jrsath/ROS2_ESP32_RaspberryPi_Automated_Assembly_Line/group4_project2_AL/report/README.md

# Report draft

`report.tex` uses the supplied ACRA style. Build with `pdflatex report.tex` twice.
The figures have editable SVG versions and a Python generator.

Replace Group 4 with the final author names. Add the measured lab results and
update the validation section after the revised simulation and physical trials.
The current draft deliberately does not claim physical assembly or inspection
results that have not been measured. Keep the finished report within four pages.
