jrsath/ROS2_ESP32_RaspberryPi_Automated_Assembly_Line/group4_project2_AL/models/packaging/README.md

# Packaging meshes

Separated from the university Box_Lower.stl. No new holder or rails are added.

- box.stl: open body, centred halfway up its 24mm height.
- lid.stl: cover and handle; origin is the underside of the lid roof.
- X is width, Y is length, Z is up. Units are metres.
