jrsath/ROS2_ESP32_RaspberryPi_Automated_Assembly_Line/group4_project2_AL/report/board_interface.pdf

# Project 2 | Board interface

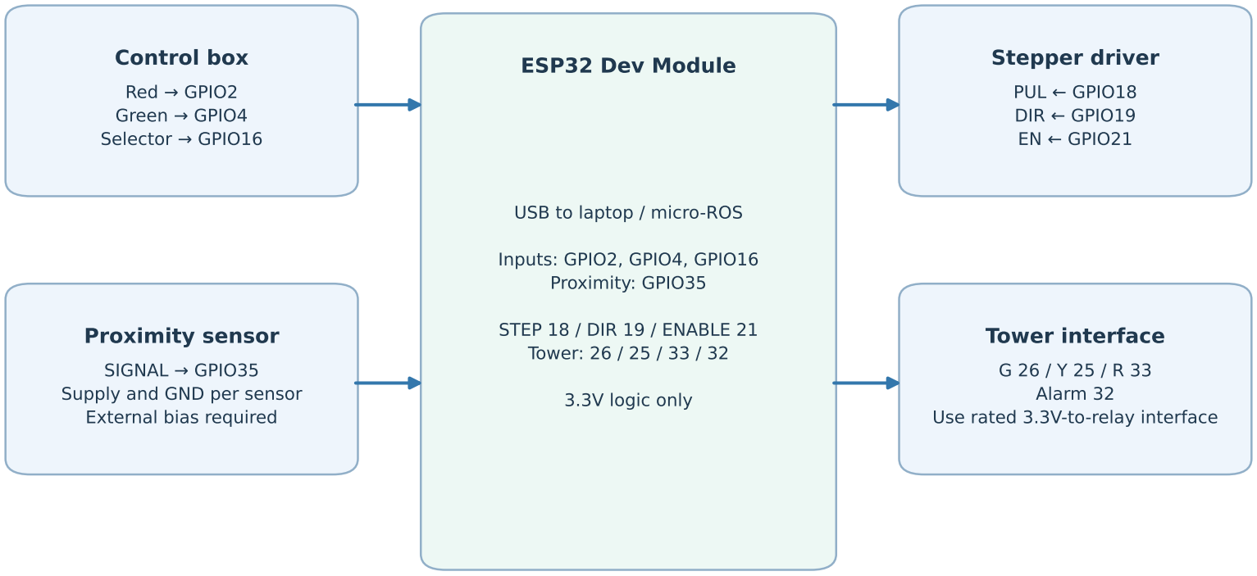
[picture p2: figure]
ESP32 Dev Module; USB to laptop / micro-ROS; Inputs: GPIO2, GPIO4, GPIO16 Proximity: GPIO35; STEP 18 / DIR 19 / ENABLE 21 Tower: 26 / 25 / 33 / 32; 3.3V logic only; Control box; Red; GPIO2; Green; GPIO4; Selector; GPIO16; Proximity sensor; SIGNAL; GPIO35; Supply and GND per sensor External bias required; Stepper driver; PUL; GPIO18; DIR; GPIO19; GPIO21; Tower interface; G 26 / Y 25 / R 33 Alarm 32 Use rated 3.3V-to-relay interface

NC E-stop: separate hardwired power-cut circuit. Feedback pin is not yet assigned.

Pin labels transcribed from the supplied sketch. Connector order and input polarity require confirmation.

Do not connect the tower relay supply or a 5V sensor output directly to an ESP32 GPIO.
