jrsath/ROS2_ESP32_RaspberryPi_Automated_Assembly_Line/group4_project2_AL/report/inspection_trials.csv

sample | actual_condition | prediction | removed_correctly | camera_bypassed | image_file | notes
1 | good
2 | good
3 | good
4 | good
5 | missing_gear
6 | unseated_insert
