jrsath/ROS2_ESP32_RaspberryPi_Automated_Assembly_Line/group4_project2_AL/report/physical_runs.csv

trial | start_time | assembly_s | conveyor_s | inspection_s | packaging_s | total_s | complete_success | maximum_position_error_mm | grip_failure | notes
1
2
3
4
5
