jrsath/ROS2_ESP32_RaspberryPi_Automated_Assembly_Line/group4_project2_AL/report/board_interface.png

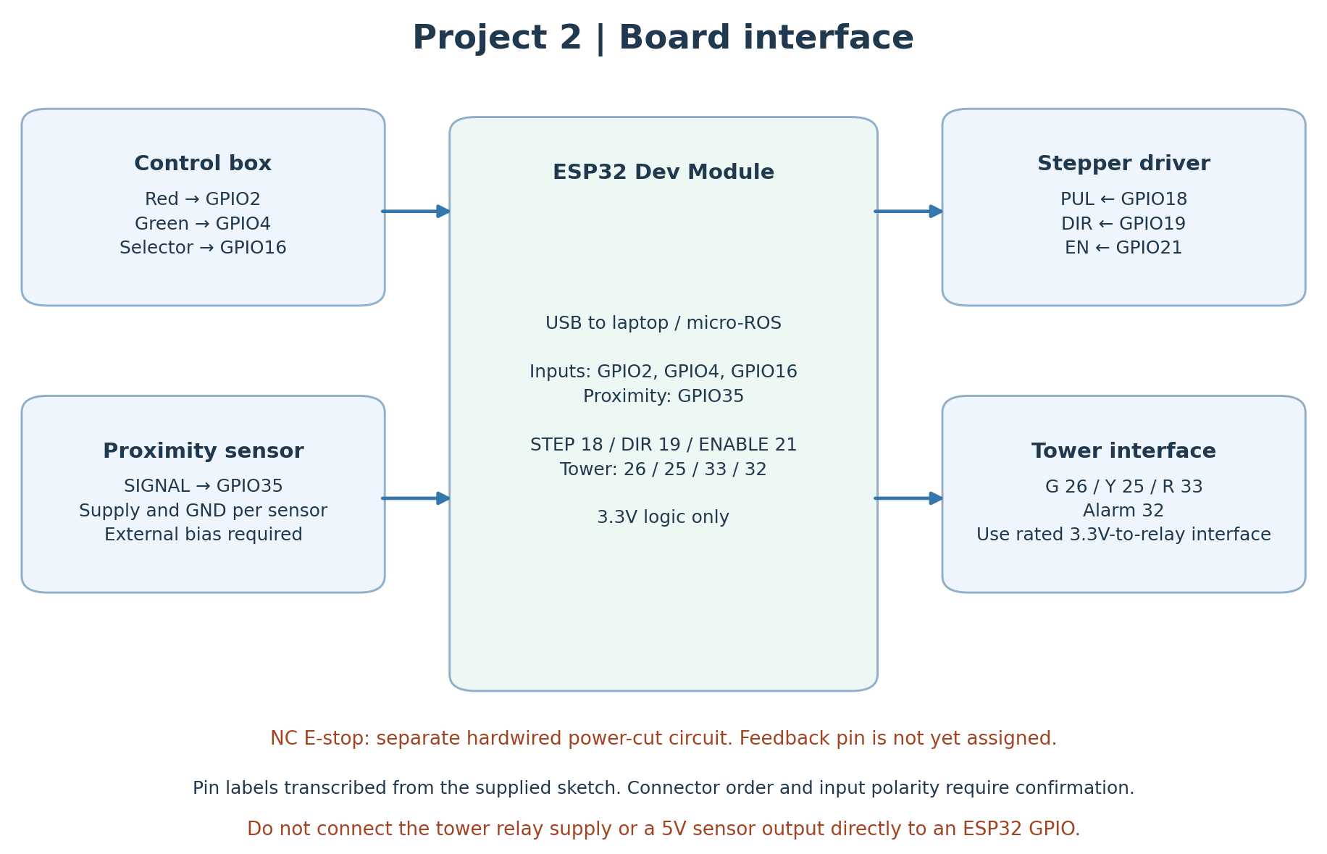
group4_project2_AL/report/board_interface.png
