jrsath/ROS2_ESP32_RaspberryPi_Automated_Assembly_Line/group4_project2_AL/models/v6/assembly_jig.stl

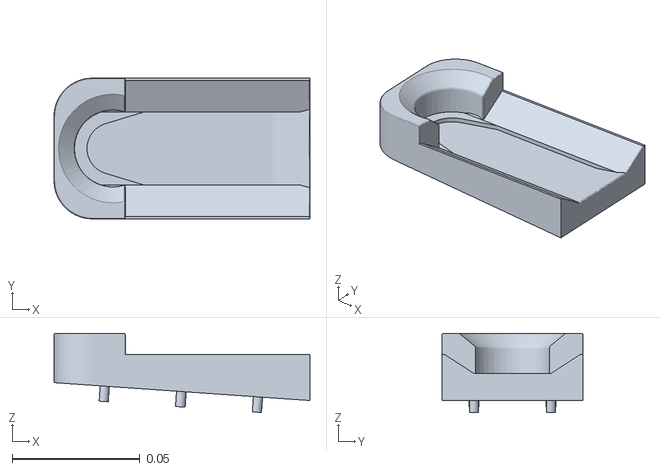
[picture p5: CAD file, 2026-10-29]
group4_project2_AL/models/v6/assembly_jig.stl
0.1 x 0.055 x 0.0309
