jrsath/ROS2_ESP32_RaspberryPi_Automated_Assembly_Line/group4_project2_AL/models/product/1_assembled.STL

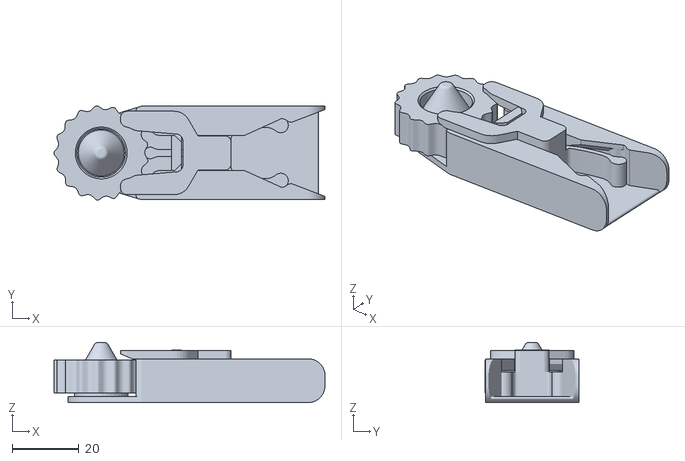
[picture p6: CAD file, 2026-10-29]
group4_project2_AL/models/product/1_assembled.STL
81.2 x 28.2 x 18.0
