jrsath/ROS2_ESP32_RaspberryPi_Automated_Assembly_Line/group4_project2_AL/models/packaging/box.stl

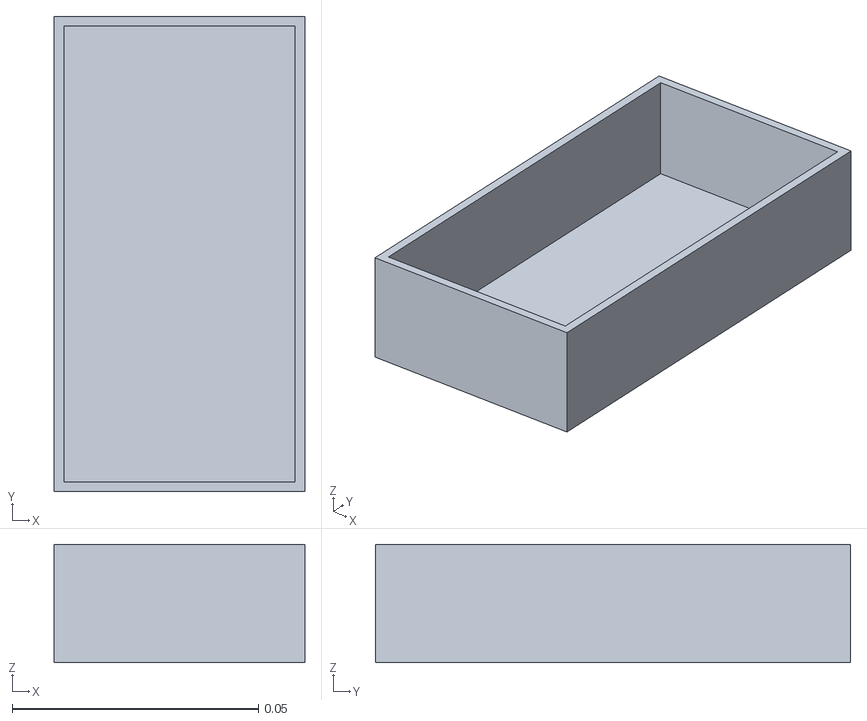
[picture p7: CAD file, 2026-10-29]
group4_project2_AL/models/packaging/box.stl
0.051 x 0.0966 x 0.024
