jrsath/ROS2_ESP32_RaspberryPi_Automated_Assembly_Line/group4_project2_AL/models/product/3V4_centered.stl

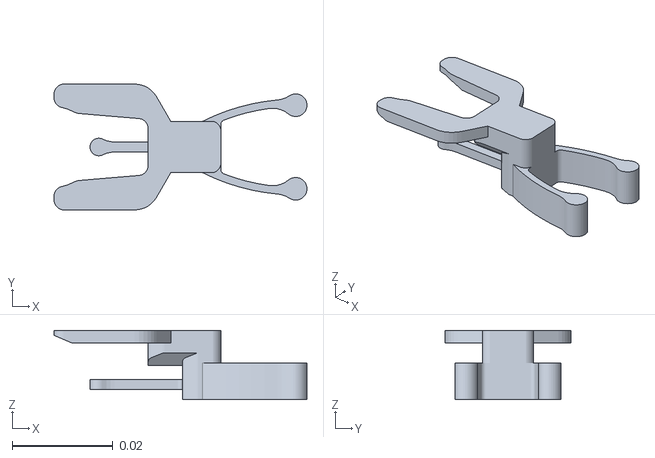
[picture p8: CAD file, 2026-10-29]
group4_project2_AL/models/product/3V4_centered.stl
0.0502 x 0.025 x 0.0138
