jrsath/ROS2_ESP32_RaspberryPi_Automated_Assembly_Line/group4_project2_AL/models/v6/2.stl

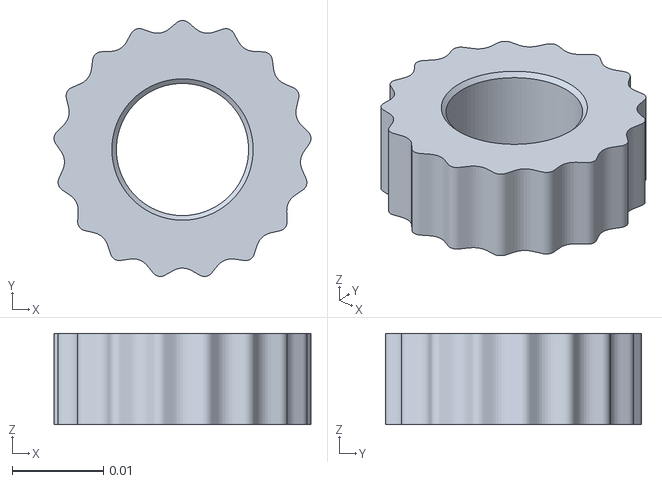
[picture p9: CAD file, 2026-10-29]
group4_project2_AL/models/v6/2.stl
0.0282 x 0.0281 x 0.01
