jrsath/ROS2_ESP32_RaspberryPi_Automated_Assembly_Line/group4_project2_AL/models/packaging/lid.stl

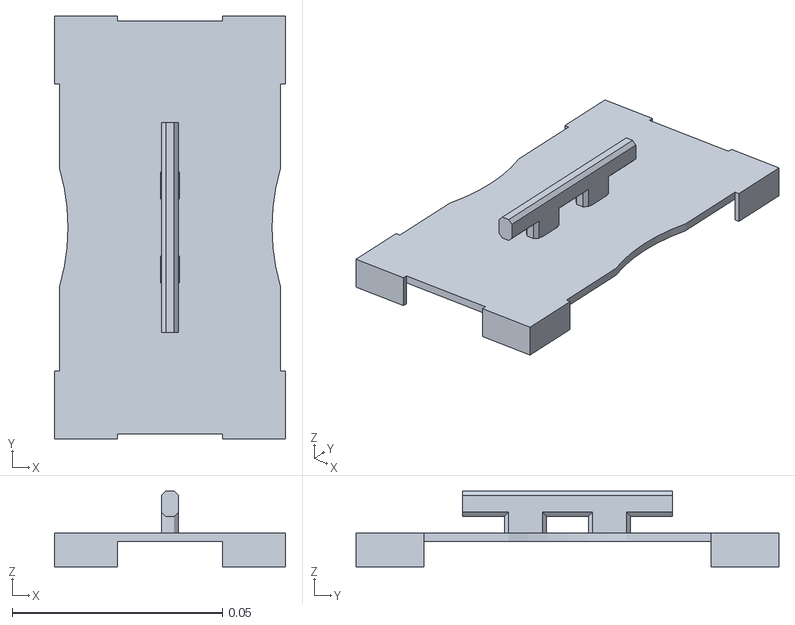
[picture p10: CAD file, 2026-10-29]
group4_project2_AL/models/packaging/lid.stl
0.0549 x 0.101 x 0.018
