jrsath/ROS2_ESP32_RaspberryPi_Automated_Assembly_Line/group4_project2_AL/models/product/1V4_centered.stl

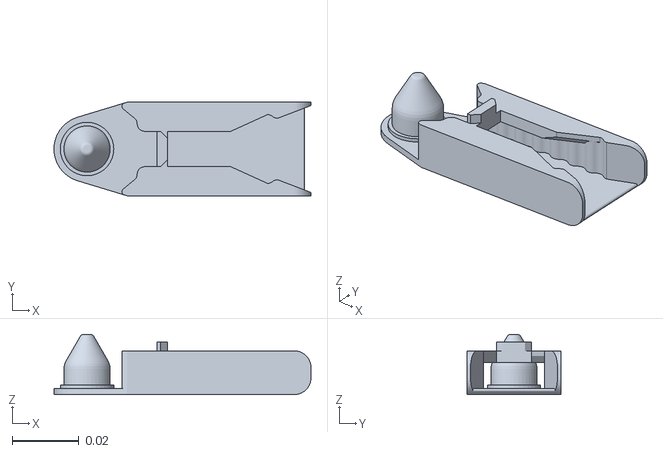
[picture p11: CAD file, 2026-10-29]
group4_project2_AL/models/product/1V4_centered.stl
0.0769 x 0.028 x 0.018
