jrsath/ROS2_ESP32_RaspberryPi_Automated_Assembly_Line/group4_project2_AL/models/v6/fork.stl

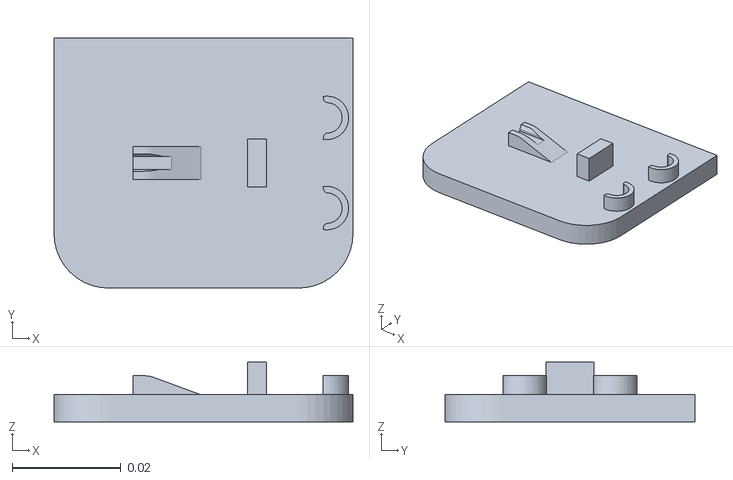
[picture p13: CAD file, 2026-10-29]
group4_project2_AL/models/v6/fork.stl
0.055 x 0.046 x 0.011
