jrsath/ROS2_ESP32_RaspberryPi_Automated_Assembly_Line/group4_project2_AL/models/v6/base.stl

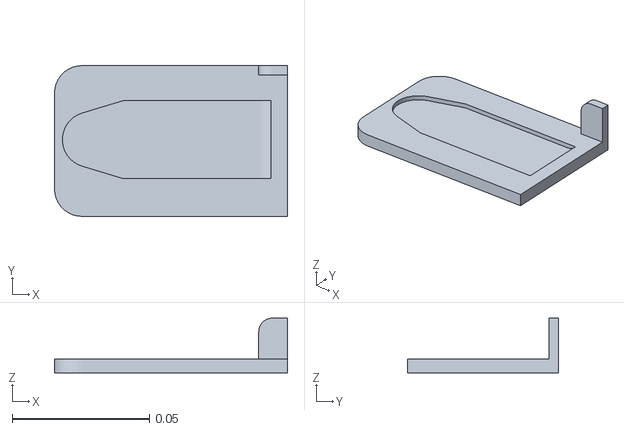
[picture p14: CAD file, 2026-10-29]
group4_project2_AL/models/v6/base.stl
0.085 x 0.055 x 0.02
