jrsath/ROS2_ESP32_RaspberryPi_Automated_Assembly_Line/group4_project2_AL/report/results.tex

% Replace each value after the physical lab trials; do not enter simulated results here.
\newcommand{\PhysicalTrials}{\textit{not measured}}
\newcommand{\PhysicalSuccesses}{\textit{not measured}}
\newcommand{\MeanCycleTime}{\textit{not measured}}
\newcommand{\MaxPositionError}{\textit{not measured}}
\newcommand{\GoodAccepted}{\textit{not measured}}
\newcommand{\MissingGearResult}{\textit{not measured}}
\newcommand{\InsertResult}{\textit{not measured}}
\newcommand{\EmergencyStopResult}{\textit{not measured}}
\newcommand{\CameraBypasses}{\textit{not measured}}
