jrsath/ROS2_ESP32_RaspberryPi_Automated_Assembly_Line/(commit log)

2026-10-19 Replace old project files with updated assembly line ZIP
2026-10-22 Upload updated Project 2 assembly line ZIP via LFS
2026-10-29 Add V6 source and station-local simulation diagnostics
    [1.stl, 1A.stl, 1V4_centered.stl, 1_assembled.STL, 2.stl, 2V4_centered.stl, 3.stl, 3V4_centered.stl]
